YUKAI/konashi-hardware/README.md

# konashi Hardware Libraries

## What
[konashi](http://konashi.ux-xu.com/)と拡張ボードで電子工作するときに役立つデータです。
