YUKAI/konashi-hardware/pcb-design/konashi1.0_eagle/konashi_rev103_実装指示書.pptx

konashi rev1.03 実装方向指示書

CN4: Top
CN5: Top
CN6: Top
CN7: Top

Top

CN6

CN4

JP5

CN7

Bottom

## Slide 2

Jumper Pin 取付指示書

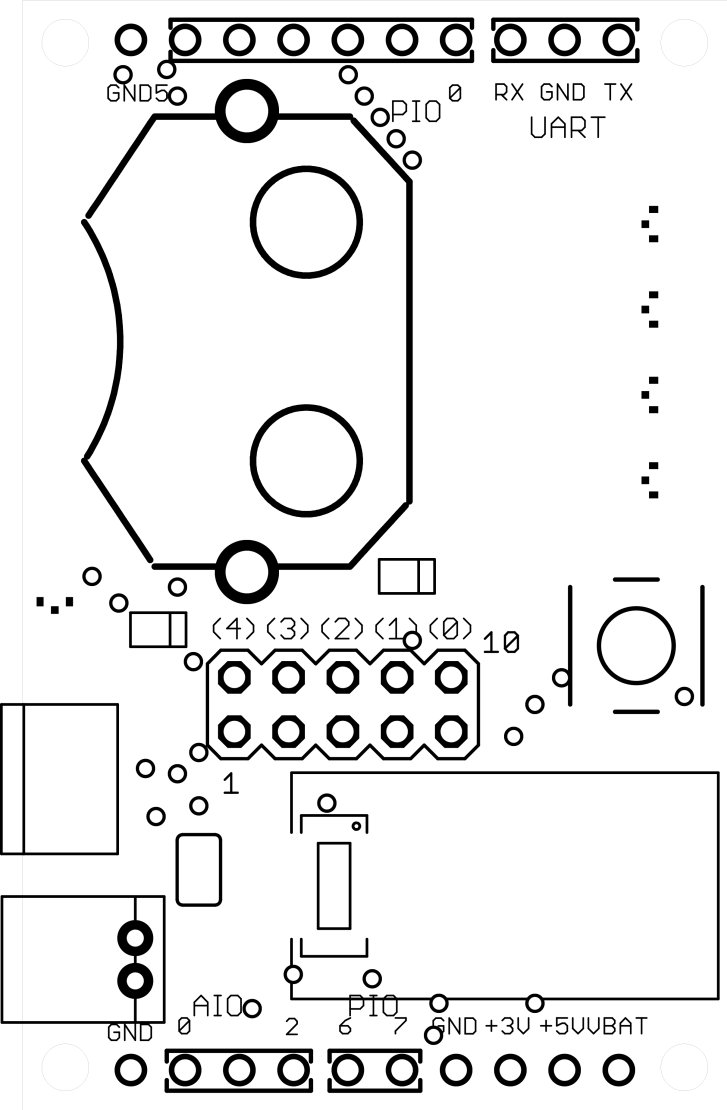
[picture p1: figure]
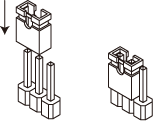
[picture p2: figure]

この位置・方向にジャンパピンを
5つ差し込みます。

Top
