YUKAI/konashi-hardware/pcb-design/konashi1.0_gerber/konashi_rev103_実装指示書.pdf

Top

Bottom

CN6

CN4: Top
CN5: Top
CN6: Top
CN4 | JP5 | CN7: Top

## konashi rev1.03 実装方向指示書

CN7

## Jumper Pin 取付指示書

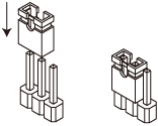
[picture p3: figure]

この位置・方向にジャンパピンを
5つ差し込みます。

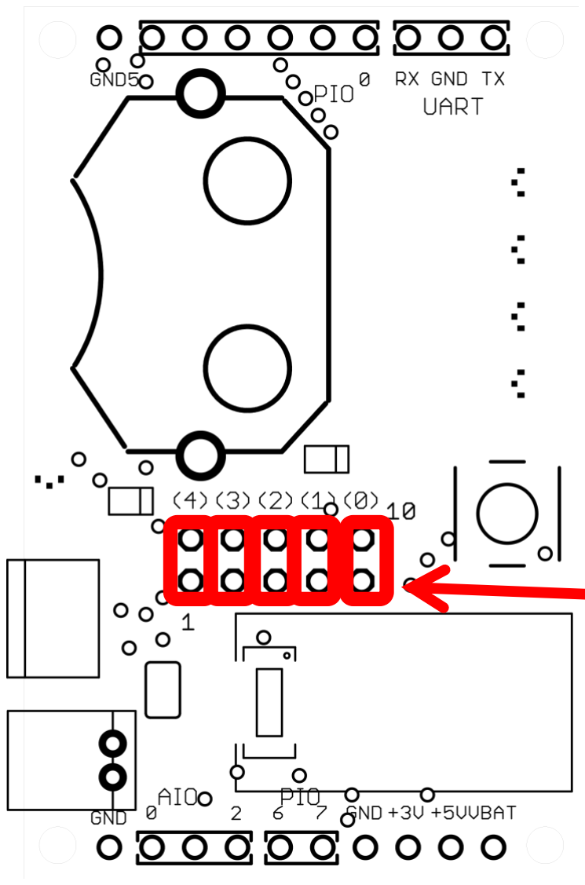
[picture p4: figure]

## Top
