YUKAI/konashi-hardware/pcb-design/ye-ex001_gerber/ex001実装方向指示書.pdf

## EX001実装方向指示書

CN3 ~ CN10

Top

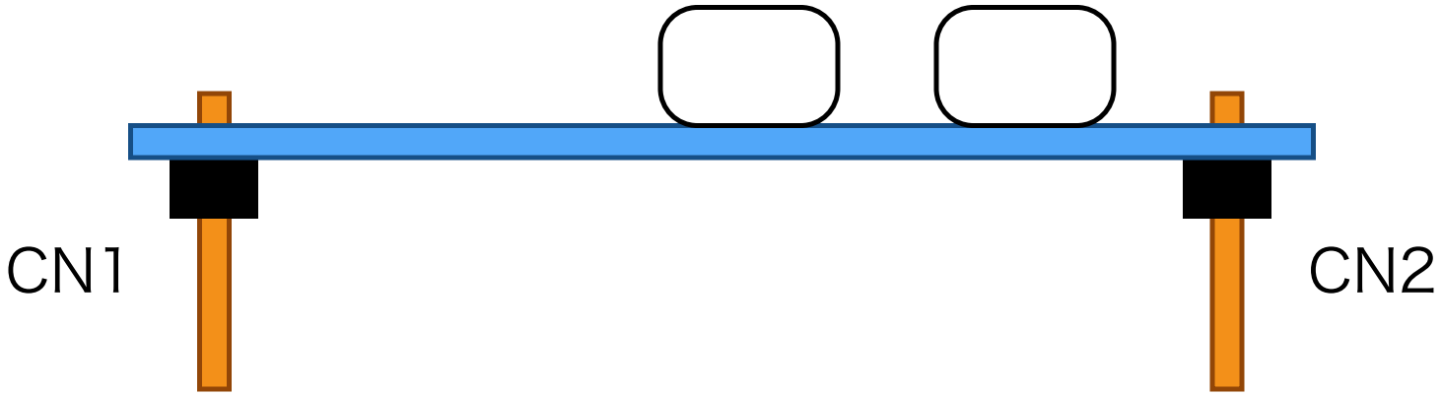
[picture p5: figure]

Bottom
