YUKAI/konashi-hardware/pcb-design/ye-ex001_gerber/1125S-SMT-XP(T).jpg

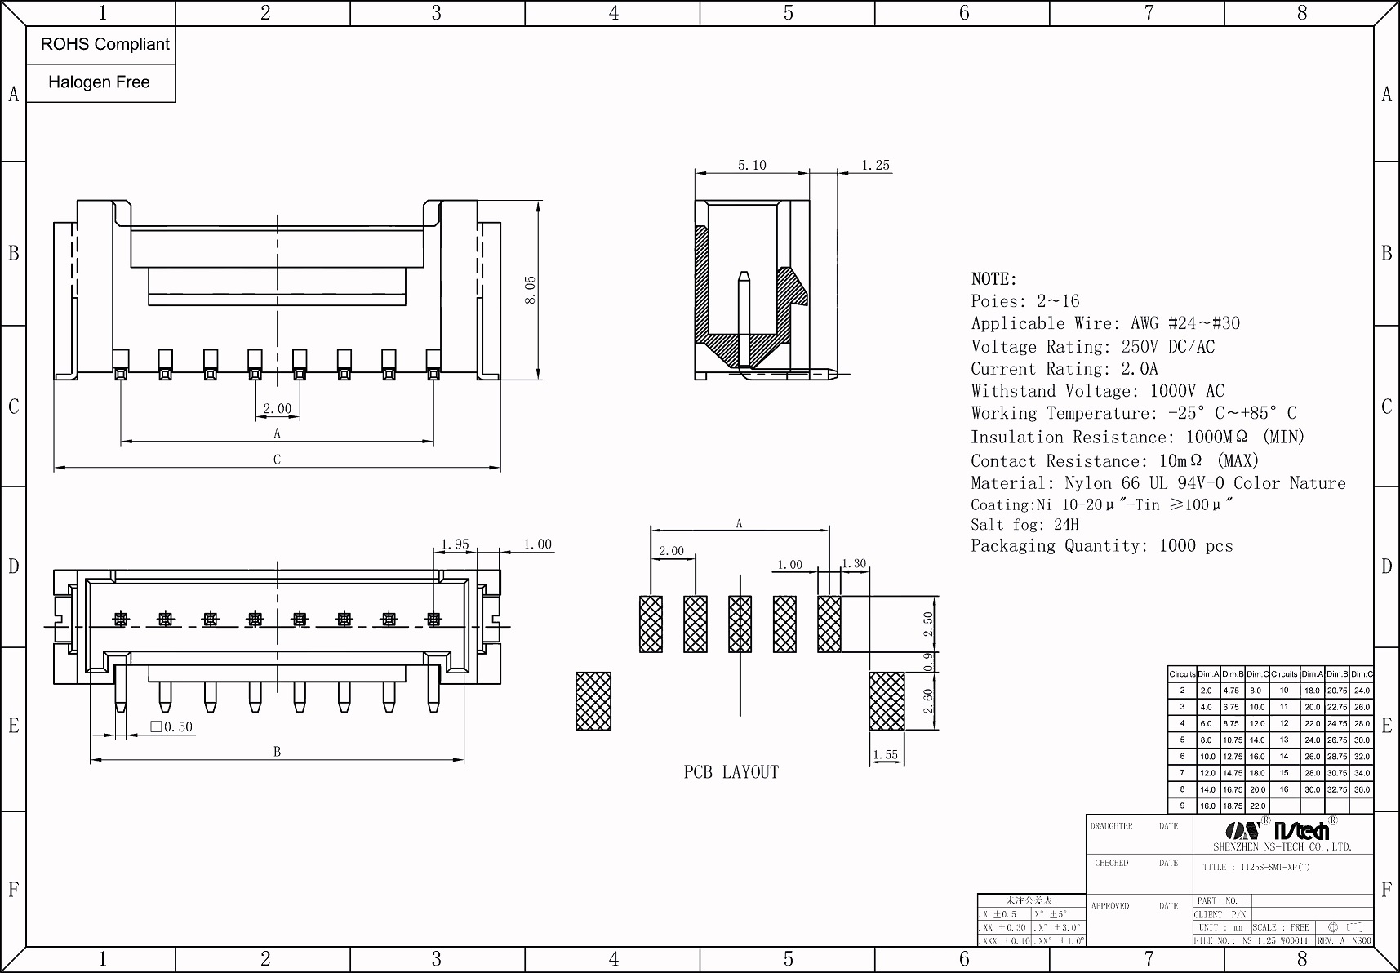
pcb-design/ye-ex001_gerber/1125S-SMT-XP(T).jpg
