YUKAI/konashi-hardware/pcb-design/ye-ex002_eagle/konashi-mini_partlist_2014-01-15.xlsx

小分類 | Part Name | 物品名 | 型番 | メーカ | 卸業者 | 必要数/1台 | 購入数 | ロット | 価格 | 小計 | 社内在庫 | 過不足 | 在庫 | 状況 | URL
プリント基板用部材 | C1,C3 | 多層セラミックコンデンサ(1uF 0603サイズ) | CGJ3E2X7R0J105K | TDK | Mouser | 1 |  |  | ¥1.300 | ¥0.000 |  |  |  |  | http://jp.mouser.com/ProductDetail/Vishay-Vitramon/VJ0603V105MXQPW1BC/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
 | C2 | 多層セラミックコンデンサ(0.1uF 25V 0603サイズ) | GRM188R71E104KA01D | Murata |  | 1 |  |  | ¥1.200 | ¥0.000 |  |  |  |  | http://jp.mouser.com/Search/ProductDetail.aspx?qs=kZszf6EFsb%252bcS4JW42Ze0A%3D%3D
 | CN3 | WML-C69用コネクタ | DF40C-20DS-0.4V(51) | Hirose Electric | Digikey | 1 |  |  | ¥53.600 | ¥0.000 |  |  |  |  | http://www.digikey.jp/product-detail/ja/DF40C-20DS-0.4V%2851%29/H11619DKR-ND/1969518
 | CN1,CN2 | ピンソケット(10pin 一列) | C-03786 | *** |  | 2 |  |  | ¥40.000 | ¥0.000
 | D1 | ショットキーバリアダイオード(Vf=0.210[V] @ If=0.1[A]) | PMEG2010ER,115 | NXP | Mouser | 1 |  |  | ¥30.100 | ¥0.000 |  |  |  |  | http://jp.mouser.com/ProductDetail/NXP/PMEG2010ER115/
 | IC1 | レギュレータ(3.0V - 10Vmax) | MCP1801T-3002I/OT | Microchip | MOUSER | 1 |  |  | ¥37.100 | ¥0.000 |  |  |  |  | http://jp.mouser.com/ProductDetail/Microchip/MCP1801T-3002I-OT/
 | ** | Bluetoothモジュール | WCL-C69 | MITSUMI | 兼松 | 1 |  |  | ¥800.000 | ¥0.000
 | ** | プリント基板 | YE-WPC001 | Yukai Engineering Inc | P板.com | 1
 |  |  |  |  |  |  |  |  |  | ¥0.000
 |  |  |  |  |  |  |  |  |  | ¥0.00
