YUKAI/konashi-hardware/pcb-design/konashi3.0_gerber/konashi_rev105_2017-07-25.xlsx

小分類 | Part Name | 物品名 | 型番 | メーカ | 卸業者 | 必要数/1台
プリント基板用部材 | C1 | 多層セラミックコンデンサ(2.2uF 0603サイズ) | GRM185R60J225KE26D | Murata Electronics North America | Digikey | 1
 | C2, C5 | 多層セラミックコンデンサ(10uF 0603サイズ) | GRM188R60J106KE47D | Murata Electronics North America | Digikey | 2
 | C3 | 多層セラミックコンデンサ(1uF 0603サイズ) | GRM188R60J105KA01D | Murata Electronics North America | Digikey | 1
 | C4 | 多層セラミックコンデンサ(0.1uF 0603サイズ) | GRM188R70J104KA01D | Murata Electronics North America | Digikey | 1
 | CN1 | USB-MicroBコネクタ | ZX62-B-5PA(33) | Hirose Electric | Digikey | 1
 | CN2 | PHコネクタ(2pin) | S2B-PH-K-S | Hirose Electric | Digikey | 1
 | CN3 | WML-C69用コネクタ | DF40C-20DS-0.4V(51) | Hirose Electric | Digikey | 1
 | CN4 | ピンヘッダ(7pin 二列) | M20-9980745 | Hawing Inc. | Digikey | 1
 | CN5, CN6 | ピンソケット(10pin 一列) | PPPC101LFBN-RC | Sullins Connector Solutions | Digikey | 2
 | Jumper Pin | ジャンパピン | M7582-46 | Harwin Inc | Digikey | 5
 | CN7 | コイン電池ホルダ | BK-913 | Memory Protection Devices Inc | Digikey | 1
 | D1, D2, D3, D4 | ショットキーバリアダイオード(Vf=0.210[V] @ If=0.1[A]) | DFLS130L-7 | DIODES Inc | Digikey | 4
 | IC1 | レギュレータ(3.0V - 16Vmax) | LP2985IM5-3.6/NOPB | TEXAS INSTRUMENTS | Digikey | 1
 | IC2 | レギュレータ(5.0V - 18Vmax) | ZLDO1117G50TA | DIODES Inc | Digikey | 1
 | LED1 | 表面実装LED(緑） 1206サイズ | 598-8270-107F | Dialight | Digikey | 1
 | LED2, LED3, LED4, LED5 | 表面実装LED(赤) 1206サイズ | 598-8210-107F | Dialight | Digikey | 4
 | R1, R2, R3, R4, R5, R6, R7 | チップ抵抗(3.3k) | RC0603FR-073K3L | Yageo | Digikey | 7
 | S1 | タクトスイッチ(SMD) | ADTSM61NVTR | Apem | Digikey | 1
