YUKAI/konashi-hardware/pcb-design/konashi1.0_gerber/konashi_rev103_2013-03-27.xlsx

小分類 | Part Name | 物品名 | 型番 | メーカ | 卸業者 | 必要数/1台
プリント基板用部材 | C1, C2, C5 | 多層セラミックコンデンサ(10uF 0603サイズ) | C1608X5R0J106M | TDK | MOUSER | 3
 | C3, C4 | 多層セラミックコンデンサ(0.1uF 0603サイズ) | VJ0603Y104JXJPW1BC | Vishay | MOUSER | 2
 | CN1 | USB-MicroBコネクタ | ZX62-B-5PA(11) | Hirose Electric | MOUSER | 1
 | CN2 | PHコネクタ(2pin) | S2B-PH-K-S | Hirose Electric | Digikey | 1
 | CN3 | WML-C69用コネクタ | DF40C-20DS-0.4V(51) | Hirose Electric | Digikey | 1
 | CN4 | ピンヘッダ(5pin 二列) | M20-9980545 | Hawing Inc. | Digikey | 1
 | CN5, CN6 | ピンソケット(10pin 一列) | PPPC101LFBN-RC | Sullins Connector Solutions | Digikey | 2
 | Jumper Pin | ジャンパピン | M7582-46 | Harwin Inc | Digikey | 5
 | CN7 | コイン電池ホルダ | BK-913 | Memory Protection Devices Inc | Digikey | 1
 | D1, D2, D3, D4 | ショットキーバリアダイオード(Vf=0.210[V] @ If=0.1[A]) | DFLS130L-7 | DIODES Inc | Digikey | 4
 | IC1 | レギュレータ(3.0V - 16Vmax) | LP2981-30DBVR | TEXAS INSTRUMENTS | MOUSER | 1
 | IC2 | レギュレータ(5.0V - 18Vmax) | ZLDO1117G50TA | DIODES Inc | MOUSER | 1
 | LED1 | 表面実装LED(緑） 1206サイズ | 598-8270-107F | Dialight | MOUSER | 1
 | LED2, LED3, LED4, LED5 | 表面実装LED(赤) 1206サイズ | 598-8210-107F | Dialight | MOUSER | 4
 | R1, R2, R3, R4, R5, R6, R7 | チップ抵抗(3.3k) | ERJ-3EKF3301V | Panasonic Electronics | Digikey | 7
 | S1 | タクトスイッチ(SMD) | ADTSM61NVTR | Apem | Digikey | 1
