YUKAI/konashi-hardware/pcb-design/ye-ex001_gerber/konashiExt001Partslist20140924.xlsx

小分類 | Part Name | 物品名 | 型番 | メーカ | 卸業者 | 必要数/1台 | 備考
プリント基板用部材 (WPC-EX001) | C1, C2 | チップコンデンサ(0.1u, 0805) | *** | *** | *** | 2
 | CN1, CN2 | ピンヘッダ(10pin, 一列) | C-00167 | *** | *** | 2
 | CN3, CN4, CN5, CN6, CN7, CN8, CN9, CN10 | Groveコネクタ 4P | 1125S-SMT-XP(T) | SHENZHEN NS-TECH | *** | 8 | 詳細は添付の資料(1125S-SMT-XP(T).jpg)を参照
 | IC1 | ADCインタフェースIC | ADS7828 | Texas Instruments | Mouser | 1 | http://jp.mouser.com/ProductDetail/Texas-Instruments/ADS7828E-250/?qs=sGAEpiMZZMuo%252bmZx5g6tFMMh6OCCbUBS
 | R1, R2 | チップ抵抗(10k, 0805) | *** | *** | *** | 3
 | R3, R4, R5 | チップ抵抗(1k, 0805) | *** | *** | *** | 2
 | SW1 | 表面実装DIPスイッチ(DPDT) | GDH02STR04 | TE Connectivity | Mouser | 1
