YUKAI/konashi-hardware/pcb-design/ye-ex002_eagle/konashi-mini-bottom.pdf

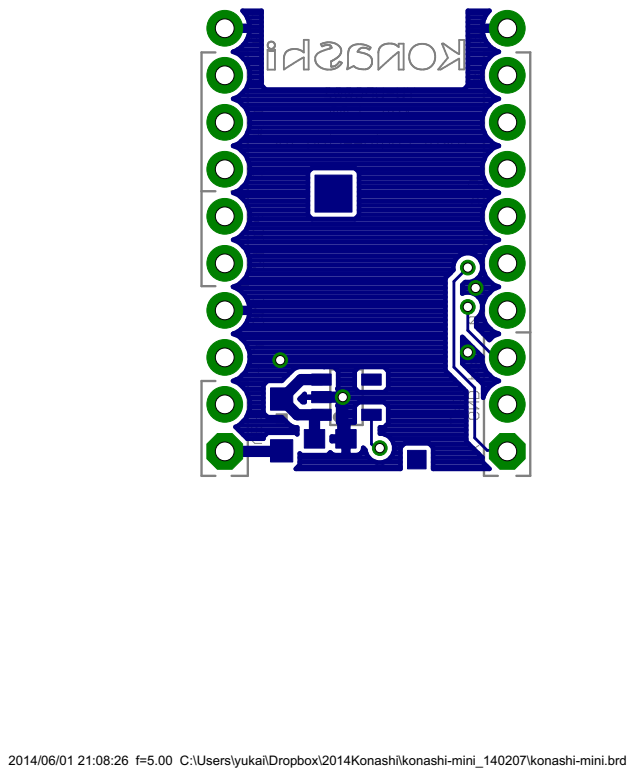
[picture p7: page 1]

2014/06/01 21:08:26 f=5.00 C:\Users\yukai\Dropbox\2014Konashi\konashi-mini_140207\konashi-mini.brd
