YUKAI/konashi-hardware/pcb-design/ye-ex002_eagle/konashi-mini-top.pdf

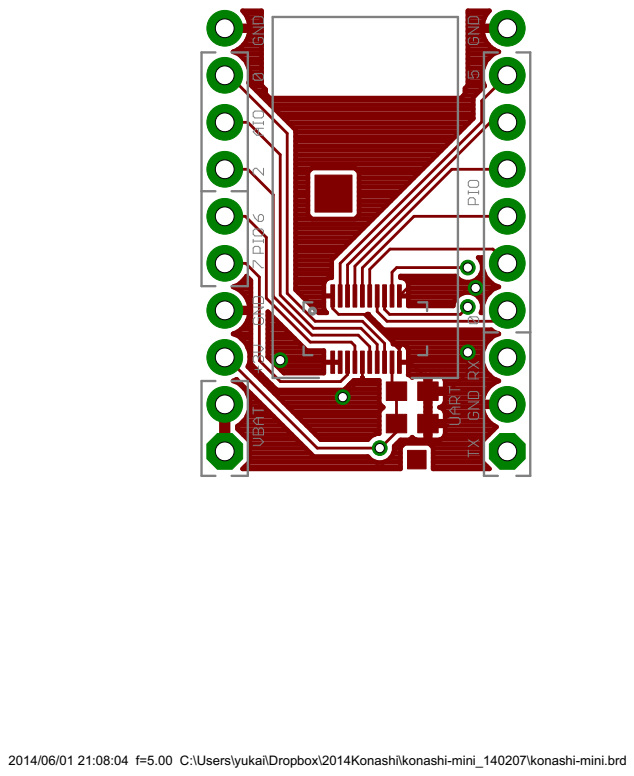
[picture p8: page 1]

2014/06/01 21:08:04 f=5.00 C:\Users\yukai\Dropbox\2014Konashi\konashi-mini_140207\konashi-mini.brd
