YUKAI/konashi-hardware/pcb-design/ye-ex002_eagle/konashi-mini_sch.pdf

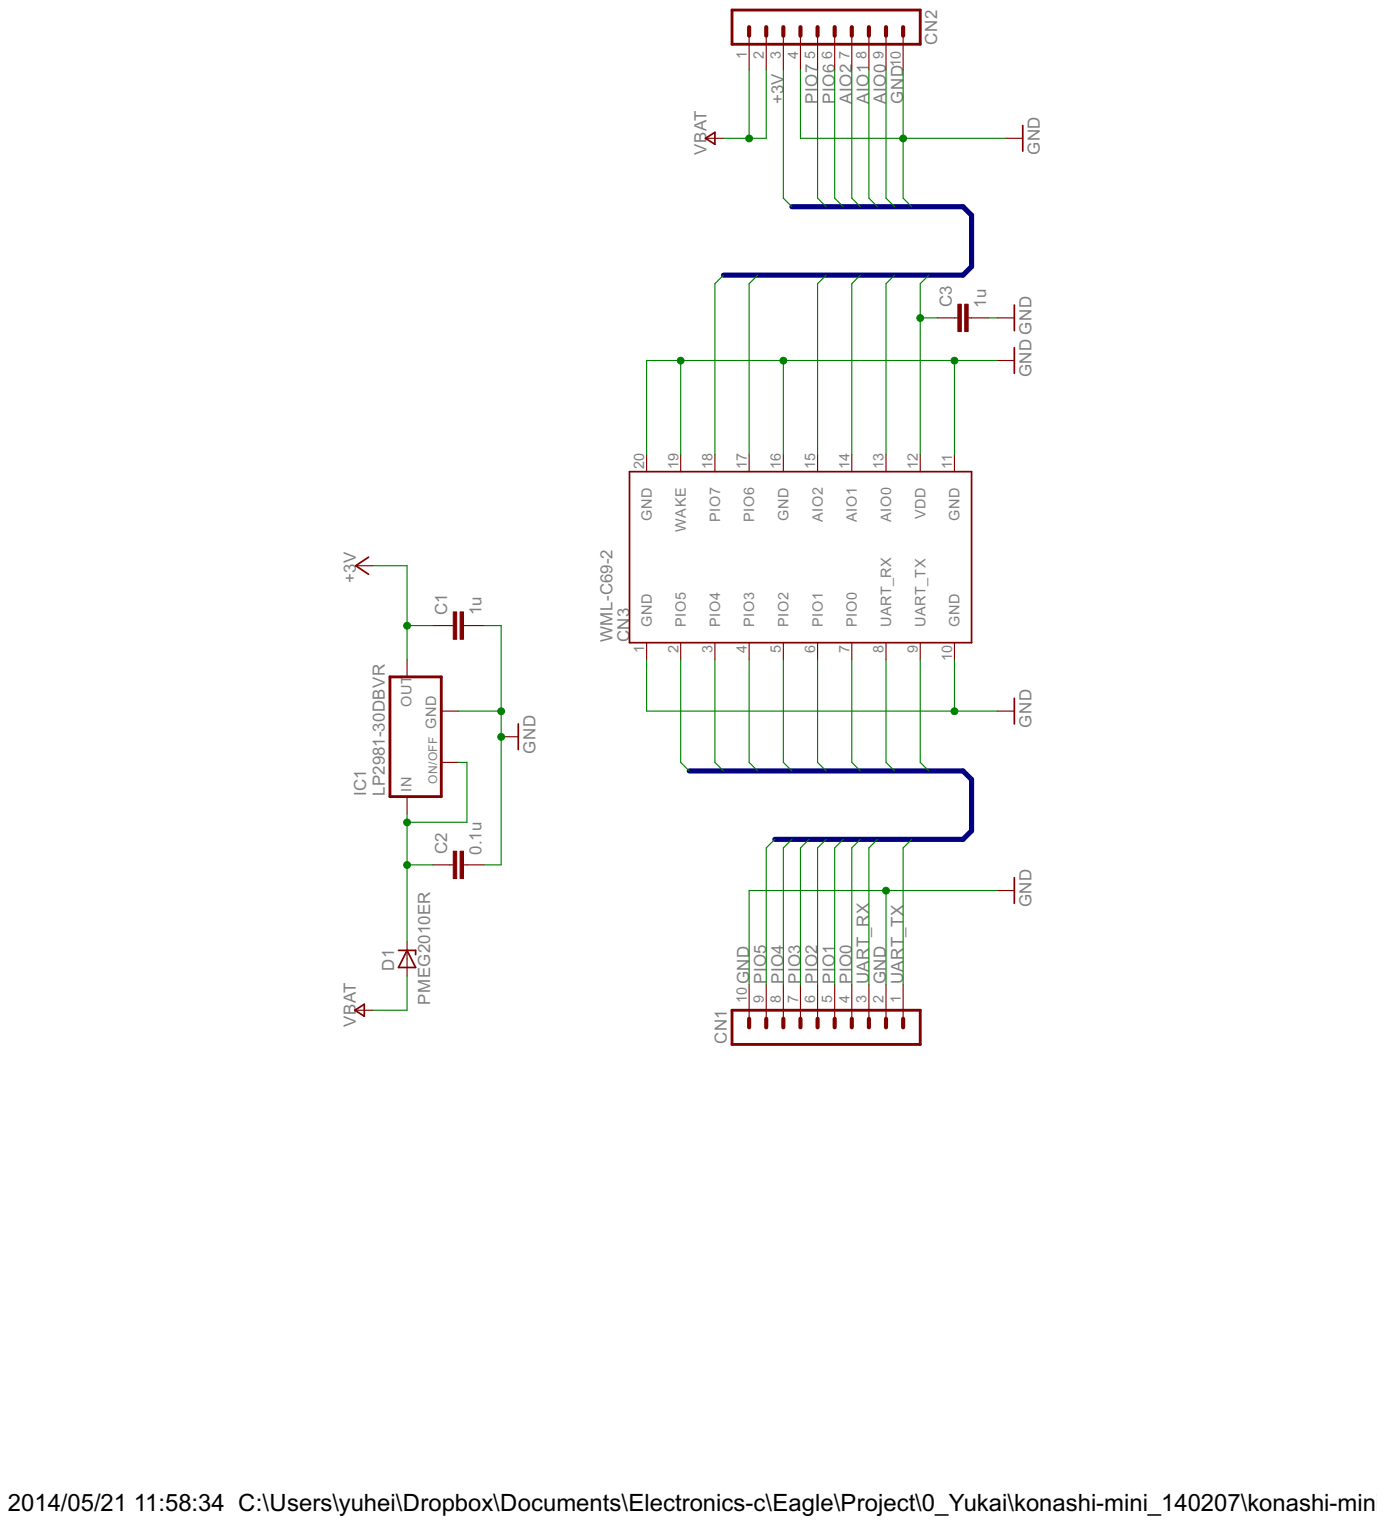
[picture p9: page 1]

IN OUT ON/OFF

2014/05/21 11:58:34 C:\Users\yuhei\Dropbox\Documents\Electronics-c\Eagle\Project\0_Yukai\konashi-mini_140207\konashi-mini.sch (Sheet: 1/1)
