YUKAI/konashi-hardware/pcb-design/konashi1.0_eagle/konashi_rev103.pdf

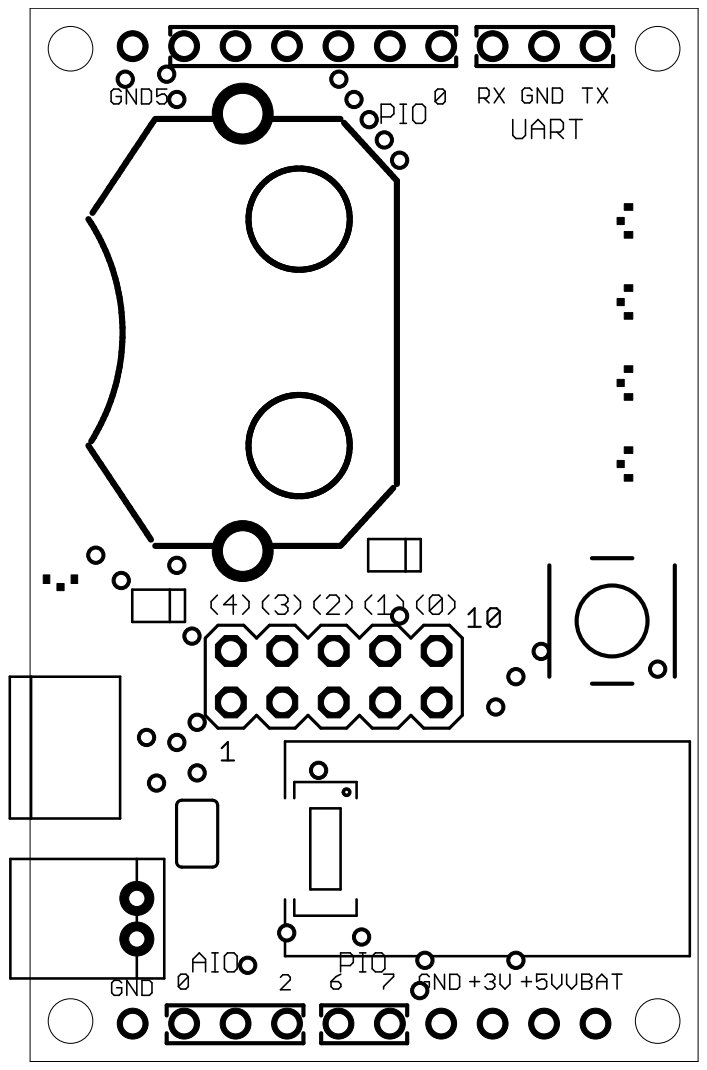
[picture p10: page 1]
