YUKAI/konashi-hardware/pcb-design/konashi2.0_gerber/konashi_rev103_cmp.pdf

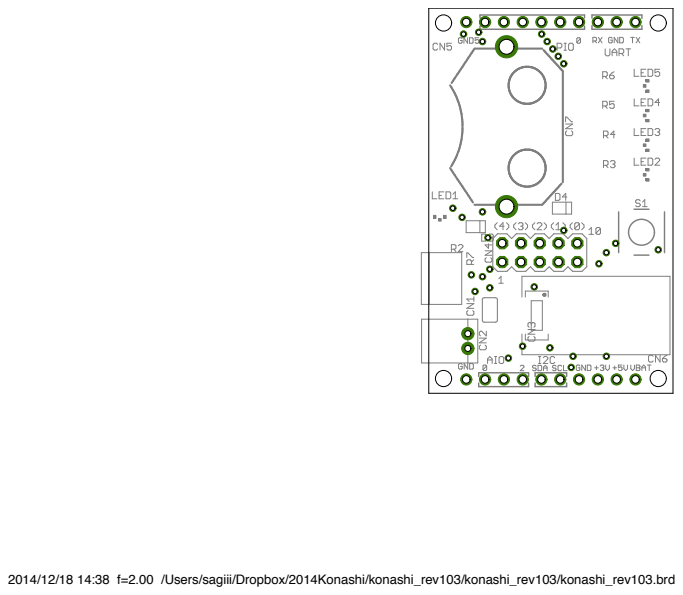
[picture p11: page 1]

2014/12/18 14:38 f=2.00 /Users/sagiii/Dropbox/2014Konashi/konashi_rev103/konashi_rev103/konashi_rev103.brd
