YUKAI/konashi-hardware/pcb-design/ye-ex002_eagle/konashi-mini.brd

## EAGLE design pcb-design/ye-ex002_eagle/konashi-mini.brd (2019-10-29)

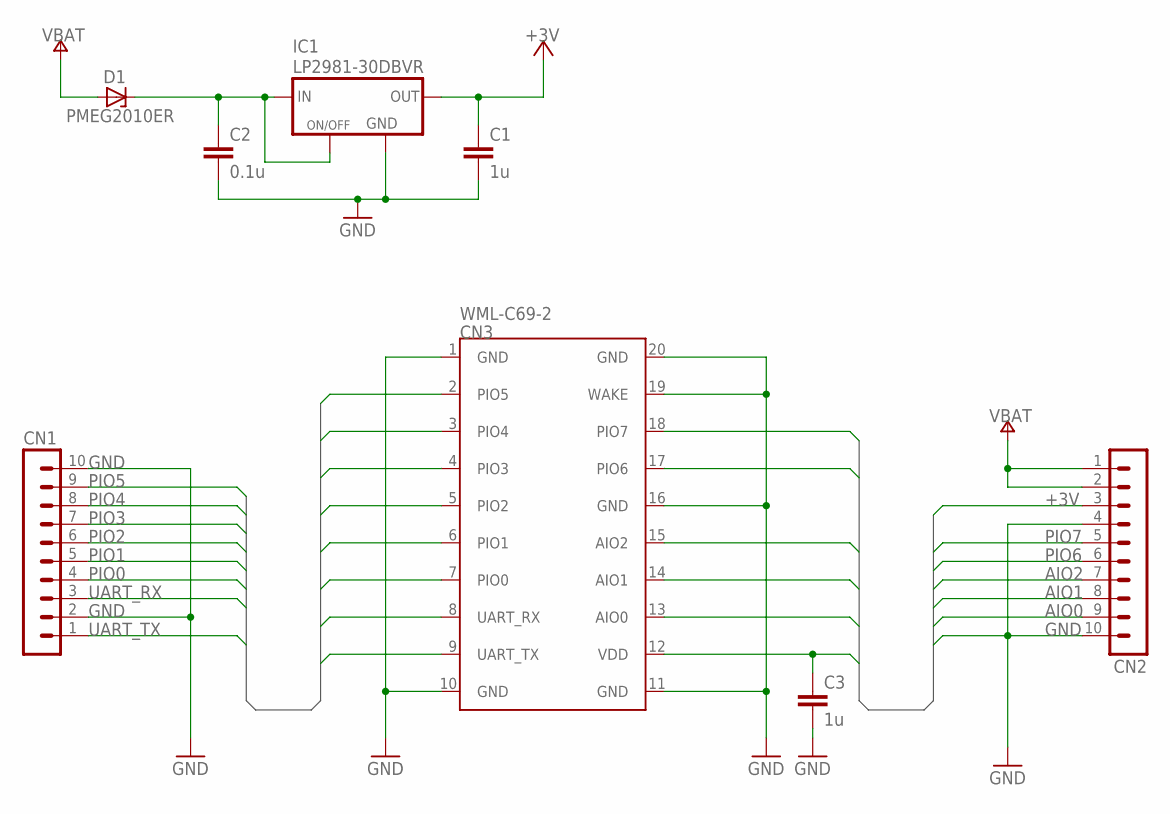
[picture p12: schematic konashi-mini.sch]

Parts:
C1, C3: 1u; C0603
C2: 0.1u; C0603
CN1, CN2: MA10-1_LARGE
CN3: WML-C69-2; WML-C69
D1: PMEG2010ER; SOD123-W
IC1: LP2981-30DBVR; SOT-23

Connections:
+3V: C1.1, C3.1, CN2.3, CN3.12 (VDD), IC1.5 (OUT)
AIO0: CN2.9, CN3.13 (AIO0)
AIO1: CN2.8, CN3.14 (AIO1)
AIO2: CN2.7, CN3.15 (AIO2)
GND: C1.2, C2.2, C3.2, CN1.2, CN1.10, CN2.4, CN2.10, CN3.1 (GND), CN3.10 (GND), CN3.11 (GND), CN3.16 (GND), CN3.19 (WAKE), CN3.20 (GND), IC1.2 (GND)
unnamed: C2.1, D1.K (C), IC1.1 (IN), IC1.3 (ON/OFF)
PIO0: CN1.4, CN3.7 (PIO0)
PIO1: CN1.5, CN3.6 (PIO1)
PIO2: CN1.6, CN3.5 (PIO2)
PIO3: CN1.7, CN3.4 (PIO3)
PIO4: CN1.8, CN3.3 (PIO4)
PIO5: CN1.9, CN3.2 (PIO5)
PIO6: CN2.6, CN3.17 (PIO6)
PIO7: CN2.5, CN3.18 (PIO7)
UART_RX: CN1.3, CN3.8 (UART_RX)
UART_TX: CN1.1, CN3.9 (UART_TX)
VBATT: CN2.1, CN2.2, D1.A

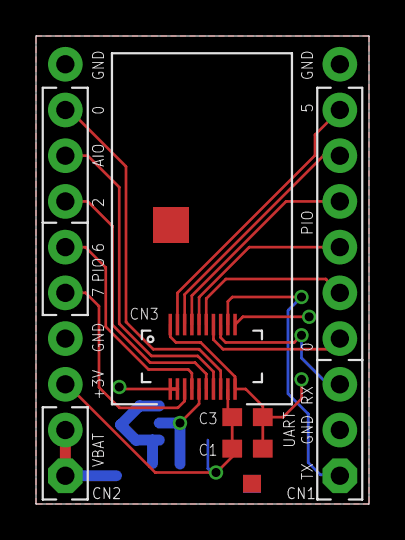
[picture p13: board konashi-mini.brd from above]

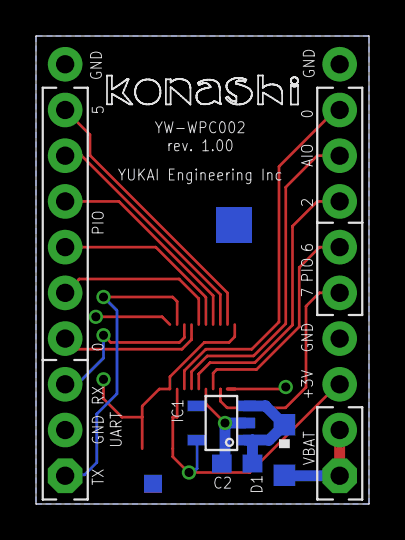
[picture p14: board konashi-mini.brd from below]

Board: 2 copper layers, 18.5 x 26.0 mm, 9 parts (4 on the bottom side), 17 nets.

Other parts of the board:
U$4: KONASHI_LOGO_WIRE_MINI
