YUKAI/konashi-hardware/pcb-design/konashi3.0_eagle/konashi_rev105.brd

## EAGLE design pcb-design/konashi3.0_eagle/konashi_rev105.brd (2017-07-25)

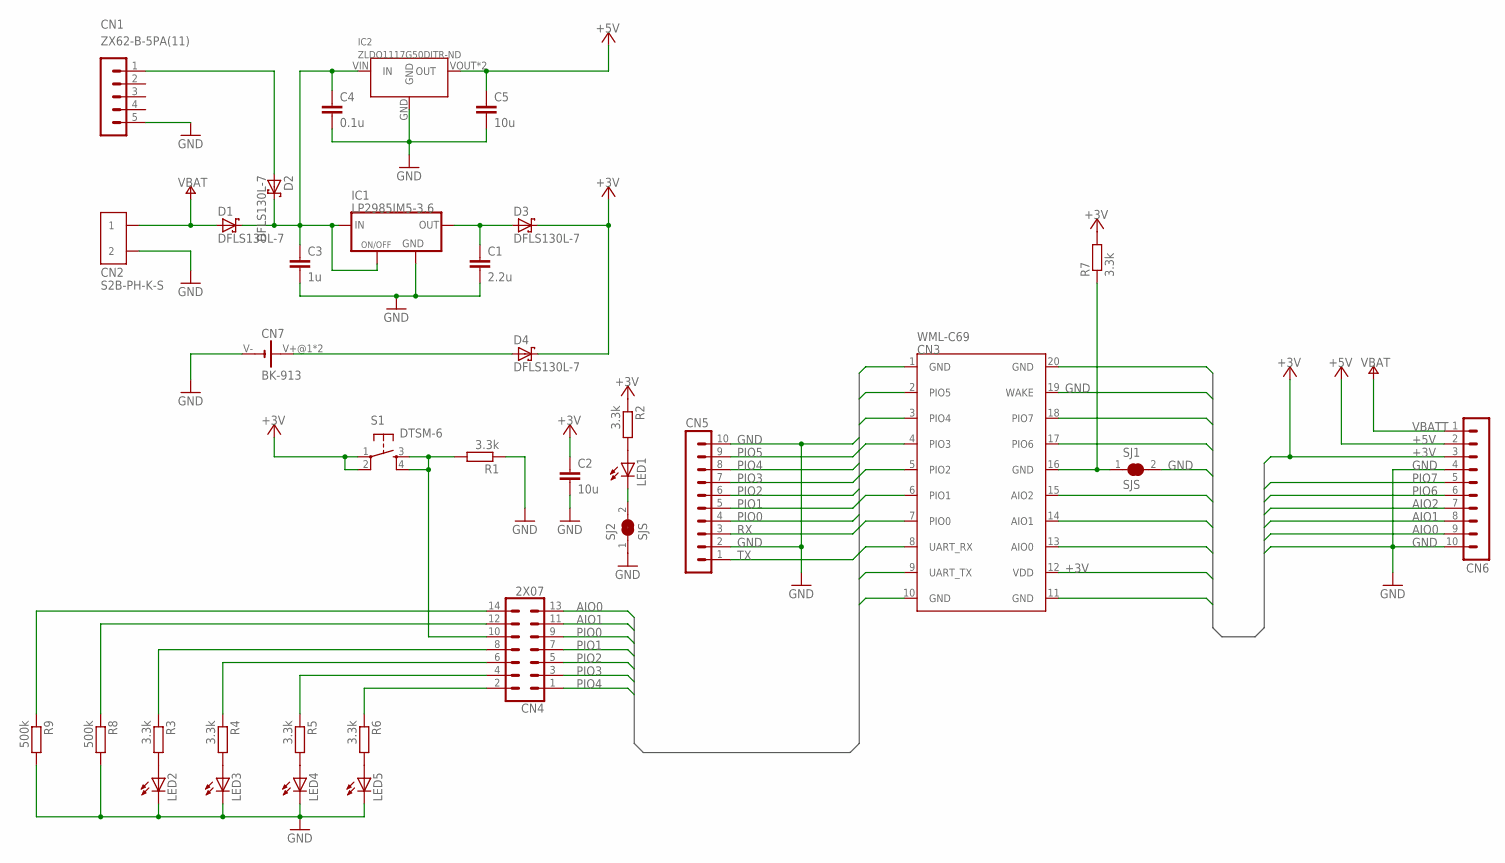
[picture p15: schematic konashi_rev105.sch]

Parts:
C1: 2.2u; C0603
C2, C5: 10u; C0603
C3: 1u; C0603
C4: 0.1u; C0603
CN1: ZX62-B-5PA(11); MICRO-B
CN2: S2B-PH-K-S
CN3: WML-C69
CN4: 2X07
CN5, CN6: MA10-1
CN7: BK-913
D1, D2, D3, D4: DFLS130L-7; DFLS130L
IC1: LP2985IM5-3.6; SOT-23
IC2: ZLDO1117G50DITR-ND; SOD233
LED1, LED2, LED3, LED4, LED5: LEDCHIPLED_1206; CHIPLED_1206
R1, R2, R3, R4, R5, R6, R7: 3.3k; R0603
R8, R9: 500k; R0603
S1: DTSM-6
SJ1, SJ2: SJS

Connections:
+3V: C2.1, CN3.12 (VDD), CN6.3, D3.C, D4.C, R2.1, R7.2, S1.1, S1.2
+5V: C5.1, CN6.2, IC2.VOUT (OUT), IC2.VOUT2 (OUT)
AIO0: CN3.13 (AIO0), CN4.13, CN6.9
AIO1: CN3.14 (AIO1), CN4.11, CN6.8
AIO2: CN3.15 (AIO2), CN6.7
GND: C1.2, C2.2, C3.2, C4.2, C5.2, CN1.5 (5.GND), CN2.P$2 (2), CN3.1 (GND), CN3.10 (GND), CN3.11 (GND), CN3.19 (WAKE), CN3.20 (GND), CN5.2, CN5.10, CN6.4, CN6.10, CN7.V- (-), IC1.2 (GND), IC2.GND, LED2.C, LED3.C, LED4.C, LED5.C, R1.1, R8.2, R9.2, SJ1.2, SJ2.1
unnamed: LED3.A, R4.2
unnamed: LED2.A, R3.2
unnamed: LED1.C, SJ2.2
unnamed: CN7.V+@1 (+), CN7.V+@2 (+), D4.A
unnamed: CN3.16 (GND), R7.1, SJ1.1
unnamed: C1.1, D3.A, IC1.5 (OUT)
unnamed: CN4.12, R8.1
unnamed: C3.1, C4.1, D1.C, D2.C, IC1.1 (IN), IC1.3 (ON/OFF), IC2.VIN (IN)
unnamed: LED5.A, R6.2
unnamed: LED4.A, R5.2
unnamed: CN4.14, R9.1
unnamed: LED1.A, R2.2
unnamed: CN4.10, R1.2, S1.3, S1.4
unnamed: CN4.6, R4.1
unnamed: CN4.2, R6.1
unnamed: CN4.4, R5.1
unnamed: CN4.8, R3.1
unnamed: CN1.1 (1.VBUS), D2.A
PIO0: CN3.7 (PIO0), CN4.9, CN5.4
PIO1: CN3.6 (PIO1), CN4.7, CN5.5
PIO2: CN3.5 (PIO2), CN4.5, CN5.6
PIO3: CN3.4 (PIO3), CN4.3, CN5.7
PIO4: CN3.3 (PIO4), CN4.1, CN5.8
PIO5: CN3.2 (PIO5), CN5.9
PIO6: CN3.17 (PIO6), CN6.6
PIO7: CN3.18 (PIO7), CN6.5
RX: CN3.8 (UART_RX), CN5.3
TX: CN3.9 (UART_TX), CN5.1
VBATT: CN2.P$1 (1), CN6.1, D1.A

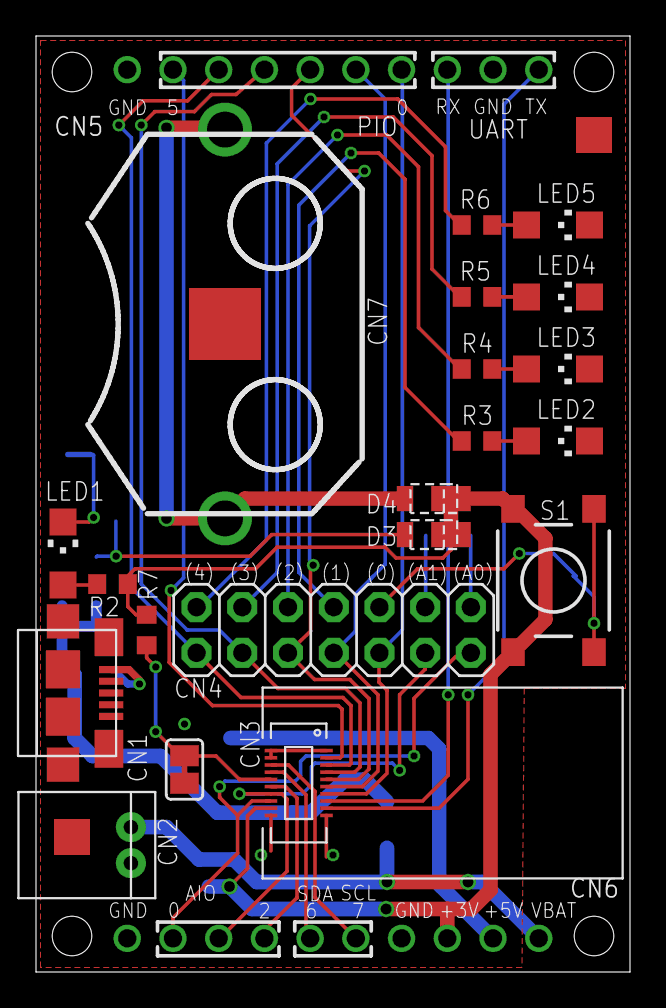
[picture p16: board konashi_rev105.brd from above]

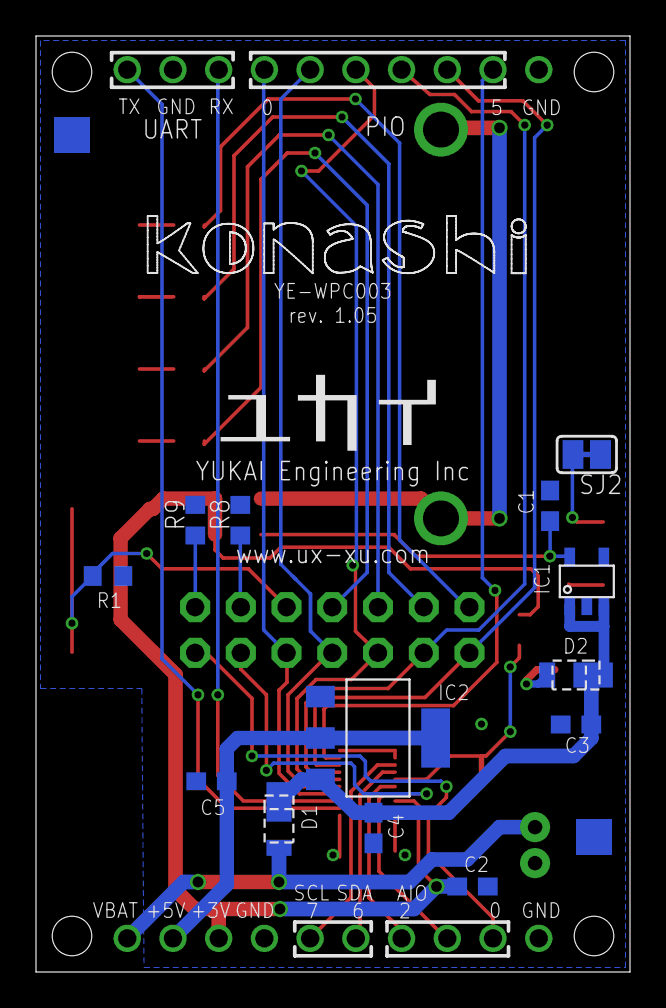
[picture p17: board konashi_rev105.brd from below]

Board: 2 copper layers, 33.0 x 52.0 mm, 37 parts (15 on the bottom side), 35 nets.

Other parts of the board:
U$13: KONASHI_LOGO_WIRE
U$14: YUKAILOGO
