YUKAI/konashi-hardware/(commit log)

2017-07-20 Add konashi base board's design and production data
    [konashi_rev103.brd, konashi_rev103.sch, konashi_rev103_2013-03-27.xlsx]
2017-07-21 konashi3.0_eagle追加
    [konashi_rev105.brd, konashi_rev105.sch]
2017-07-24 500kohm追加、ジャンパ用ピンヘッダ変更
    [konashi_rev105.brd, konashi_rev105.sch]
2017-07-24 シルク修正
    [konashi_rev105.brd]
2017-07-25 ジャンパピンシルク追加等
    [konashi_rev105.brd, konashi_rev105.sch]
2017-07-25 ガーバーデータ追加、レギュレータ型番変更
    [konashi_rev105.GBL, konashi_rev105.GBO, konashi_rev105.GBP, konashi_rev105.GBS, konashi_rev105.GTL, konashi_rev105.GTO, konashi_rev105.GTP, konashi_rev105.GTS]
2017-07-25 BOM追加
    [konashi_rev105.brd, konashi_rev105.sch, konashi_rev105_2017-07-25.xlsx]
2019-10-29 Added konashi mini
    [konashi-mini.brd, konashi-mini.sch, konashi-mini_partlist_2014-01-15.xlsx]
2019-10-29 Add YE-EX001 gerber
    [FILELIST.xls, konashiExt001Partslist20140924.xlsx]
